GadgetReboot/ESP32_5V_Dev_Board/README.md

# ESP32_5V_Dev_Board
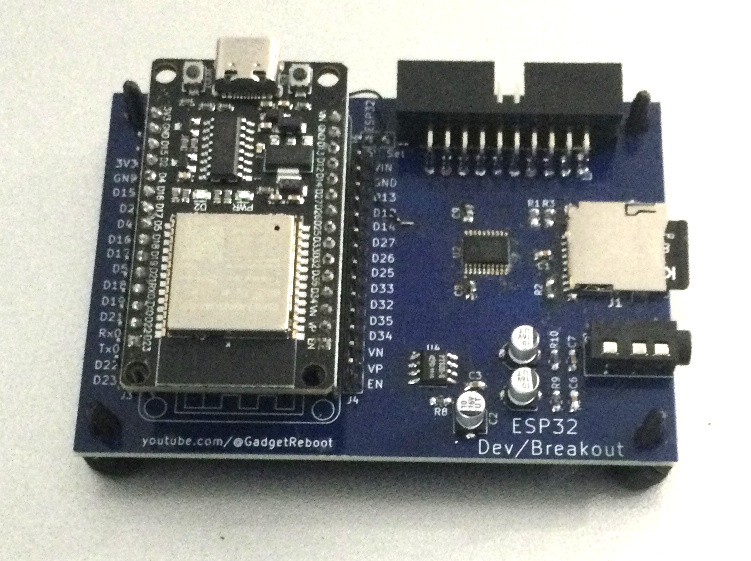
[picture p1: Assembled_PCB.jpg]
PCB
<br><br><BR><BR>
ESP32 dev board with on board 3.3v to 5v buffers to some external pins, PT8211 I2S DAC, and Micro SD Card Socket
