GadgetReboot/ESP32_5V_Dev_Board/Sch_ESP32_Breakout.pdf

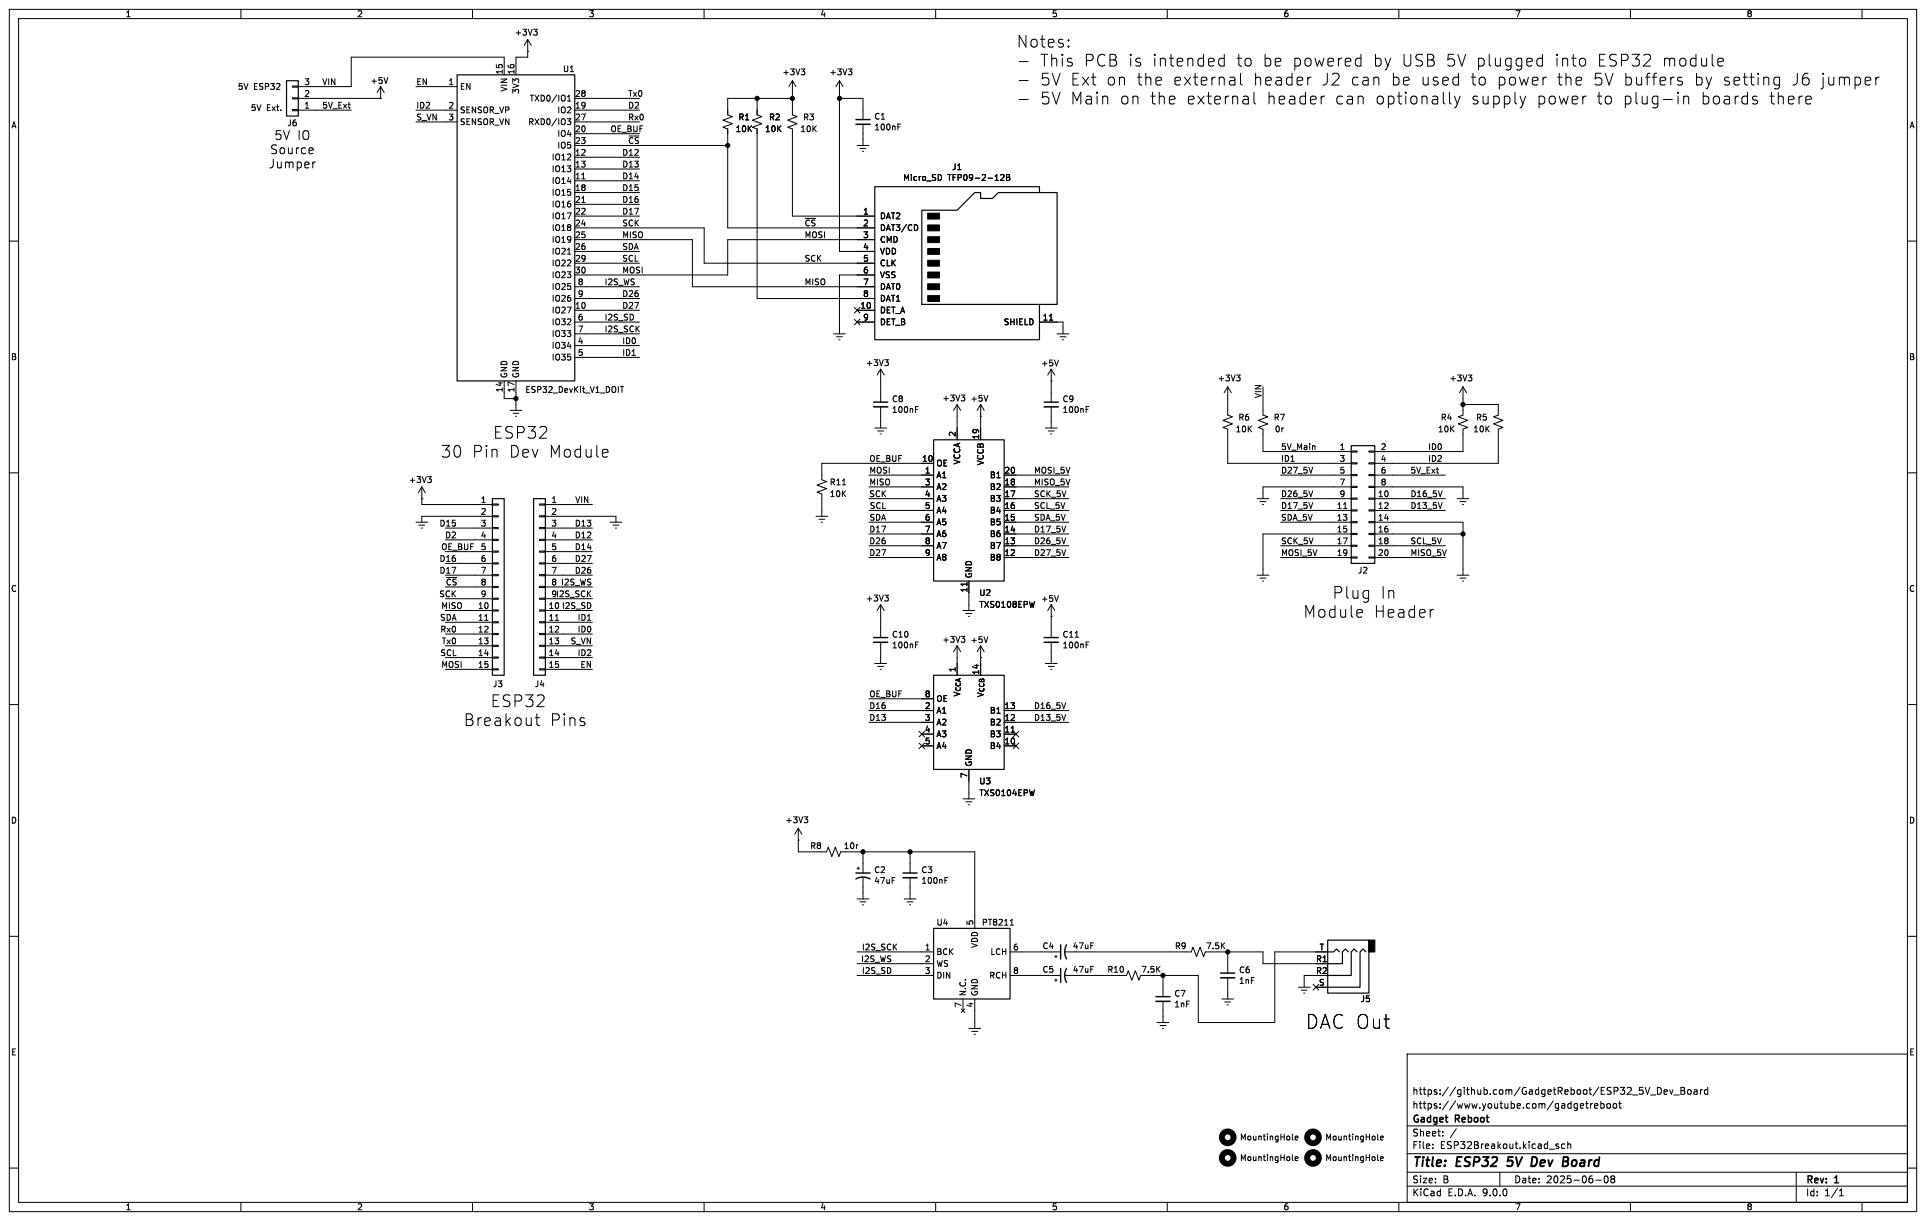
[picture p2: page 1]

https://github.com/GadgetReboot/ESP32_5V_Dev_Board

Id: 1/1 Title: ESP32 5V Dev Board
