GadgetReboot/ESP32_5V_Dev_Board/KiCad/ESP32Breakout.kicad_pcb

## KiCad design KiCad/ESP32Breakout.kicad_pcb (2025-07-10)

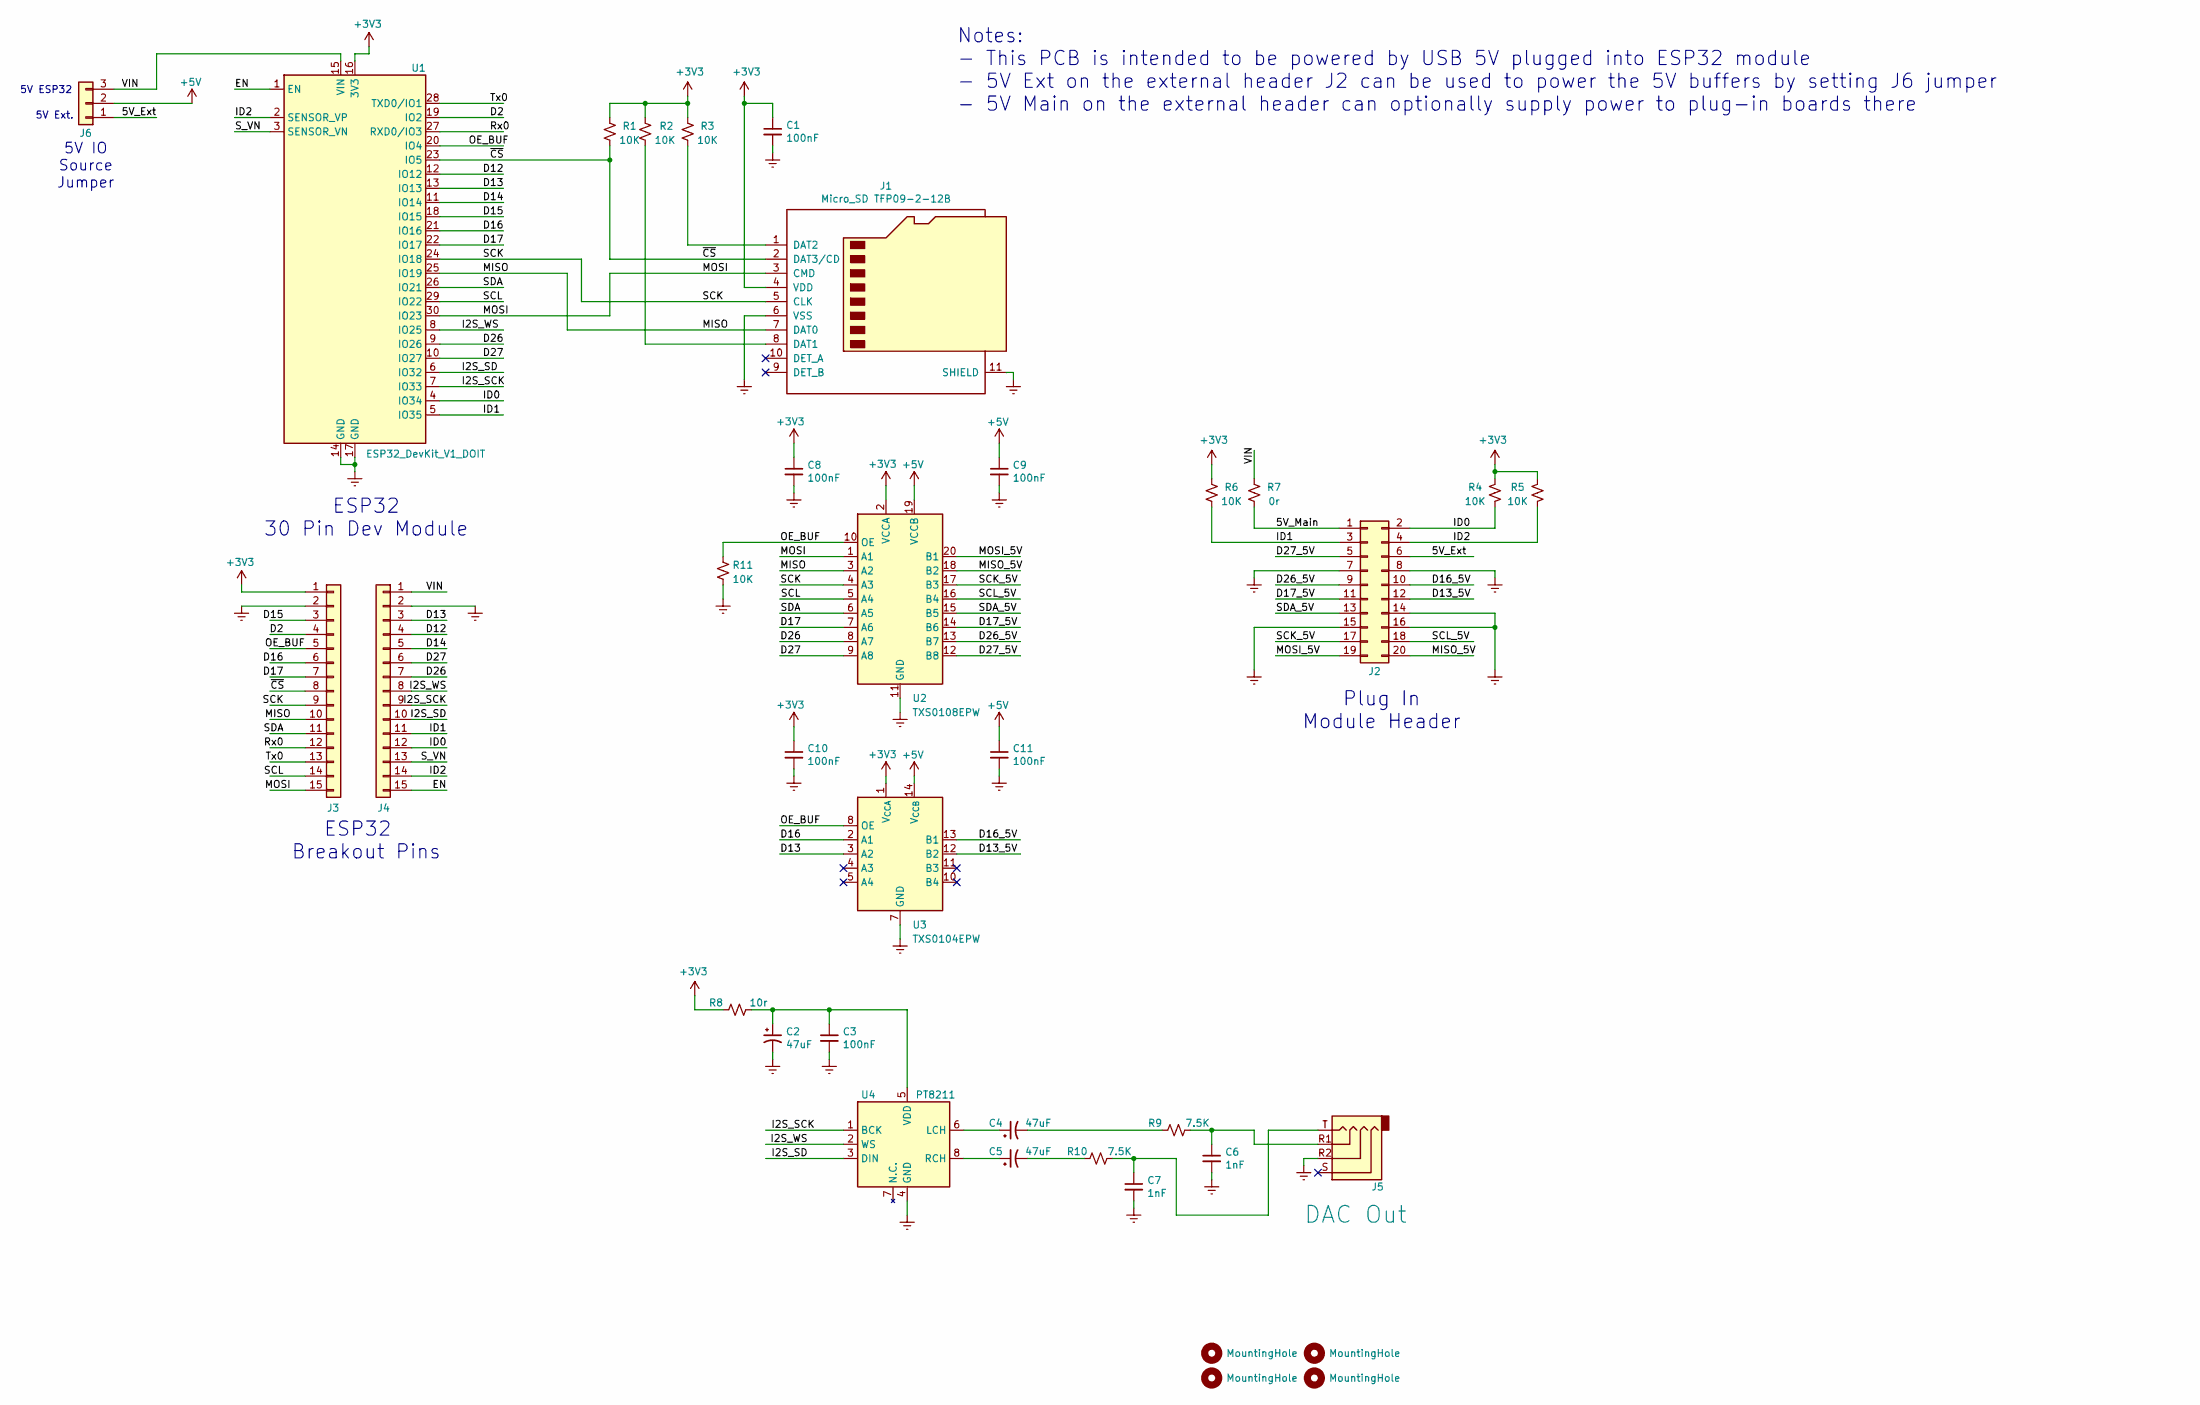
[picture p3: schematic ESP32Breakout.kicad_sch, ESP32 5V Dev Board]

Parts:
C1, C3, C8, C9, C10, C11: 100nF; C_0805_2012Metric_Pad1.18x1.45mm_HandSolder
C2, C4, C5: 47uF; C_Elec_4x5.4
C6, C7: 1nF; C_0805_2012Metric_Pad1.18x1.45mm_HandSolder
H1, H2, H3, H4: MountingHole; MountingHole_3.5mm
J1: Micro_SD TFP09-2-12B; TFP09212B
J2: Conn_02x10_Odd_Even; PinSocket_2x10_P2.54mm_Horizontal
J3, J4: Conn_01x15; PinHeader_1x15_P2.54mm_Vertical
J5: DAC Out; PJ320A
J6: Conn_01x03; PinHeader_1x03_P2.54mm_Vertical
R1, R2, R3, R4, R5, R6, R11: 10K; R_0805_2012Metric_Pad1.20x1.40mm_HandSolder
R7: 0r; R_0805_2012Metric_Pad1.20x1.40mm_HandSolder
R8: 10r; R_0805_2012Metric_Pad1.20x1.40mm_HandSolder
R9, R10: 7.5K; R_0805_2012Metric_Pad1.20x1.40mm_HandSolder
U1: ESP32_DevKit_V1_DOIT; esp32_devkit_v1_doit
U2: TXS0108EPW; TSSOP-20_4.4x6.5mm_P0.65mm
U3: TXS0104EPW; TSSOP-14_4.4x5mm_P0.65mm
U4: PT8211; SOIC-8_3.9x4.9mm_P1.27mm

Connections:
+3V3: C1.1, C8.1, C10.1, J1.4 (VDD), J3.1, R1.1, R2.1, R3.1, R4.1, R5.1, R6.1, R8.2, U1.16 (3V3), U2.2 (VCCA), U3.1 (V_{CCA})
+5V: C9.1, C11.1, J6.2, U2.19 (VCCB), U3.14 (V_{CCB})
/5V_Ext: J2.6, J6.1
/5V_Main: J2.1, R7.2
/D2: J3.4, U1.19 (IO2)
/D12: J4.4, U1.12 (IO12)
/D13: J4.3, U1.13 (IO13), U3.3 (A2)
/D13_5V: J2.12, U3.12 (B2)
/D14: J4.5, U1.11 (IO14)
/D15: J3.3, U1.18 (IO15)
/D16: J3.6, U1.21 (IO16), U3.2 (A1)
/D16_5V: J2.10, U3.13 (B1)
/D17: J3.7, U1.22 (IO17), U2.7 (A6)
/D17_5V: J2.11, U2.14 (B6)
/D26: J4.7, U1.9 (IO26), U2.8 (A7)
/D26_5V: J2.9, U2.13 (B7)
/D27: J4.6, U1.10 (IO27), U2.9 (A8)
/D27_5V: J2.5, U2.12 (B8)
/EN: J4.15, U1.1 (EN)
/I2S_SCK: J4.9, U1.7 (IO33), U4.1 (BCK)
/I2S_SD: J4.10, U1.6 (IO32), U4.3 (DIN)
/I2S_WS: J4.8, U1.8 (IO25), U4.2 (WS)
/ID0: J2.2, J4.12, R4.2, U1.4 (IO34)
/ID1: J2.3, J4.11, R6.2, U1.5 (IO35)
/ID2: J2.4, J4.14, R5.2, U1.2 (SENSOR_VP)
/MISO: J1.7 (DAT0), J3.10, U1.25 (IO19), U2.3 (A2)
/MISO_5V: J2.20, U2.18 (B2)
/MOSI: J1.3 (CMD), J3.15, U1.30 (IO23), U2.1 (A1)
/MOSI_5V: J2.19, U2.20 (B1)
/OE_BUF: J3.5, R11.1, U1.20 (IO4), U2.10 (OE), U3.8 (OE)
/Rx0: J3.12, U1.27 (RXD0/IO3)
/SCK: J1.5 (CLK), J3.9, U1.24 (IO18), U2.4 (A3)
/SCK_5V: J2.17, U2.17 (B3)
/SCL: J3.14, U1.29 (IO22), U2.5 (A4)
/SCL_5V: J2.18, U2.16 (B4)
/SDA: J3.11, U1.26 (IO21), U2.6 (A5)
/SDA_5V: J2.13, U2.15 (B5)
/S_VN: J4.13, U1.3 (SENSOR_VN)
/Tx0: J3.13, U1.28 (TXD0/IO1)
/VIN: J4.1, J6.3, R7.1, U1.15 (VIN)
/~CS: J1.2 (DAT3/CD), J3.8, R1.2, U1.23 (IO5)
GNDREF: C1.2, C2.2, C3.2, C6.2, C7.2, C8.2, C9.2, C10.2, C11.2, J1.6 (VSS), J1.11 (SHIELD), J2.7, J2.8, J2.14, J2.15, J2.16, J3.2, J4.2, J5.R2, R11.2, U1.14 (GND), U1.17 (GND), U2.11 (GND), U3.7 (GND), U4.4 (GND)
unnamed: C4.2, R9.2
unnamed: C5.2, R10.2
unnamed: C6.1, J5.R1, R9.1
unnamed: C7.1, J5.T, R10.1
unnamed: J1.8 (DAT1), R2.2
unnamed: J1.1 (DAT2), R3.2
unnamed: C4.1, U4.6 (LCH)
unnamed: C5.1, U4.8 (RCH)
unnamed: C2.1, C3.1, R8.1, U4.5 (VDD)

Notes on the sheet:
5V ESP32
5V Ext.
ESP32 Breakout Pins
Notes: - This PCB is intended to be powered by USB 5V plugged into ESP32 module - 5V Ext on the external header J2 can be used to power the 5V buffers by setting J6 jumper - 5V Main on the external header can optionally supply power to plug-in boards there
5V IO Source Jumper
Plug In Module Header
ESP32 30 Pin Dev Module

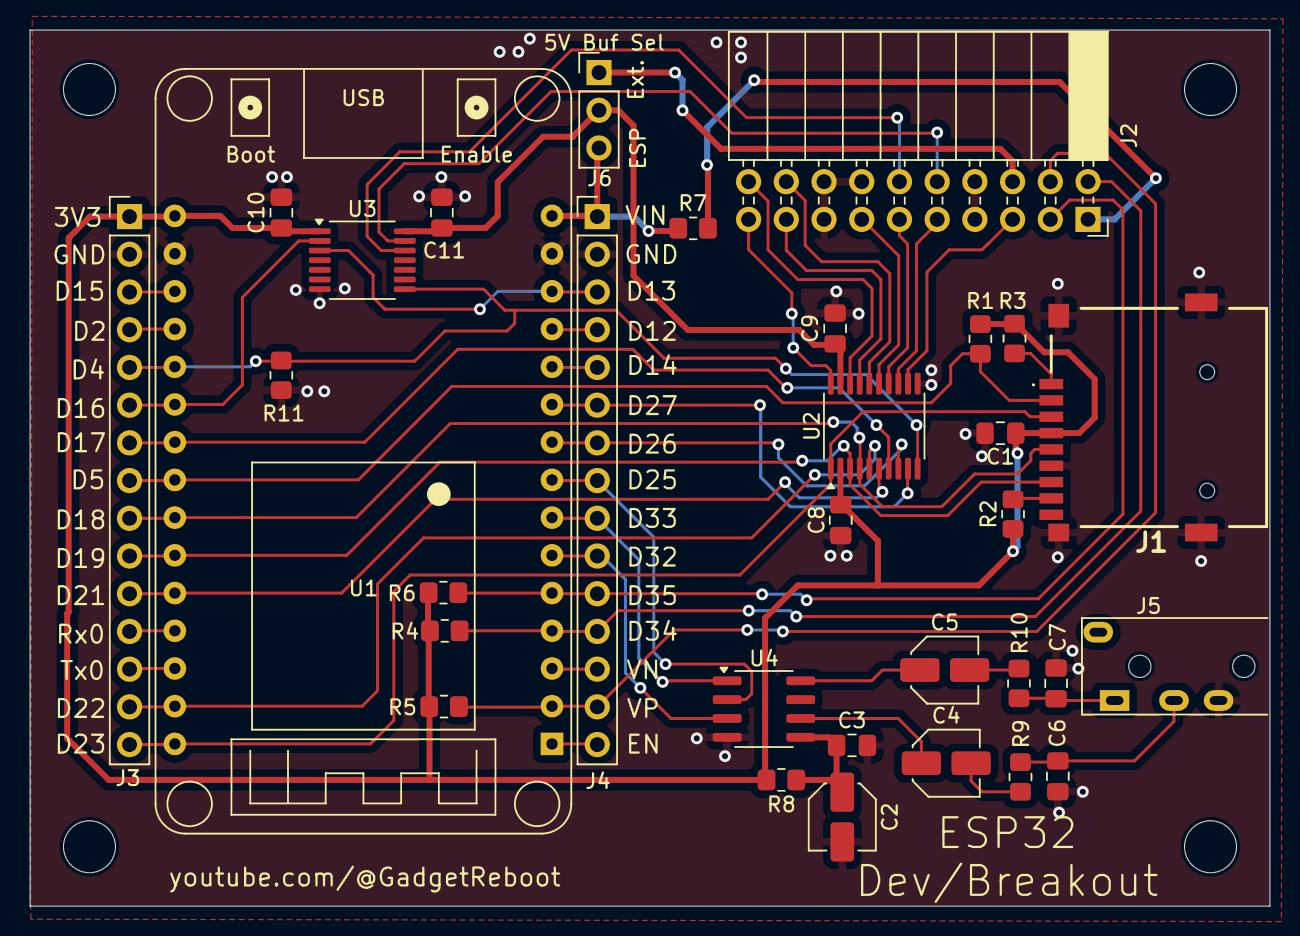
[picture p4: board ESP32Breakout.kicad_pcb from above]

Board: 2 copper layers, 83.5 x 59.0 mm, 36 parts (0 on the bottom side), 51 nets.
